desiFish/ESP32-GPS-Clock-and-Weather-Station-V1/(commit log)

2025-01-12 Add schematics and gallery sections to README.md
2025-01-12 add GPS battery modification notes to README
2025-01-12 add detailed comments and documentation to ESP32-GPS-CLOCK code and update README for project highlights
2025-01-12 add license information and copyright notice to ESP32-GPS-CLOCK-V1.ino
2025-03-01 fix URL in project notice and improve dark state tracking logic
    [ESP32-GPS-CLOCK-V1.ino]
2025-09-16 update README.md with initial setup instructions and credits; update schematic image
